KuguHome/amber-wmbus-HAT/wmbus_pihat-B.Cu.pdf

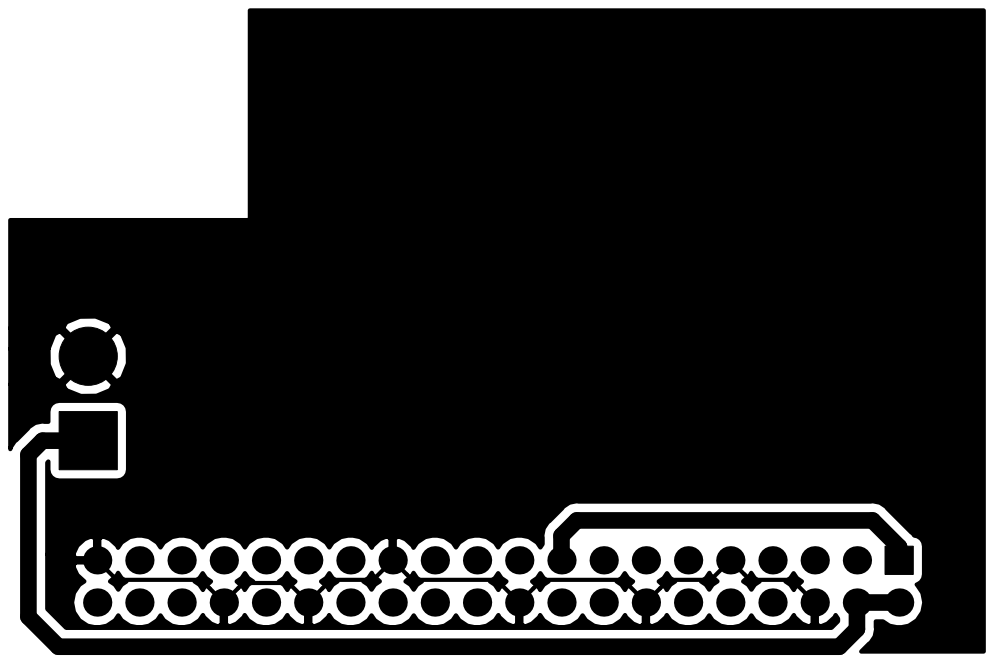
[picture p1: page 1]
