KuguHome/amber-wmbus-HAT/wmbus_pihat-B.Mask.pdf

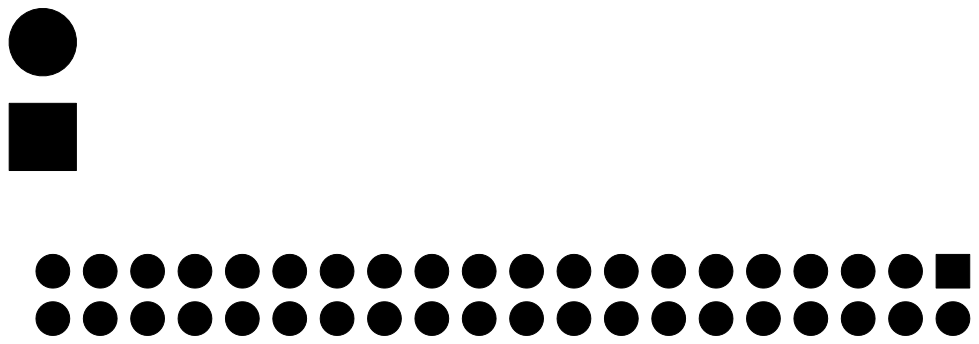
[picture p2: page 1]
