KuguHome/amber-wmbus-HAT/wmbus_pihat-F.Cu.pdf

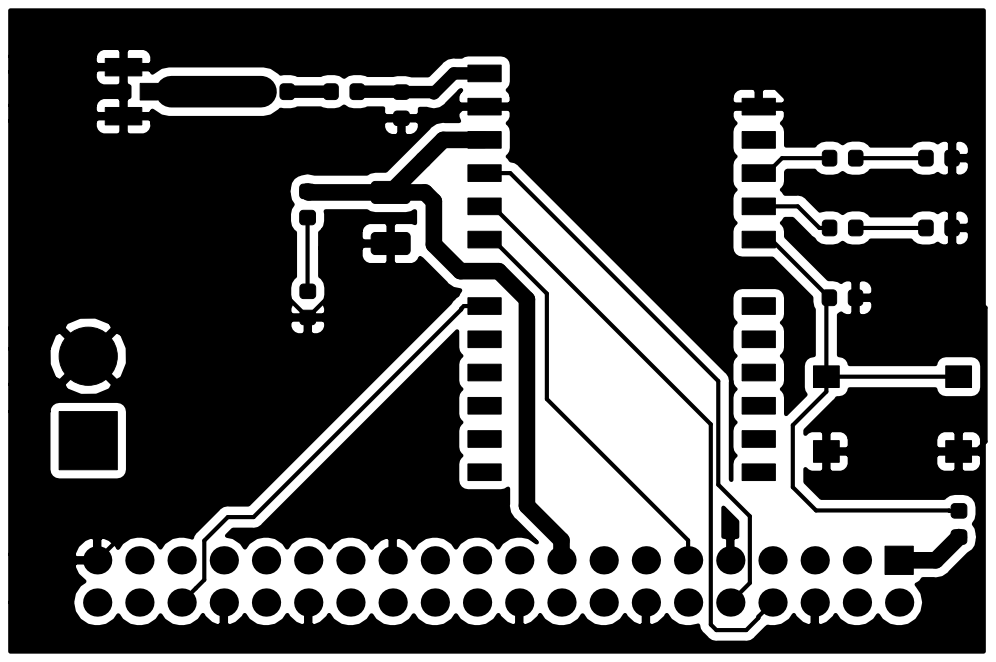
[picture p3: page 1]
