KuguHome/amber-wmbus-HAT/wmbus_pihat-F.Mask.pdf

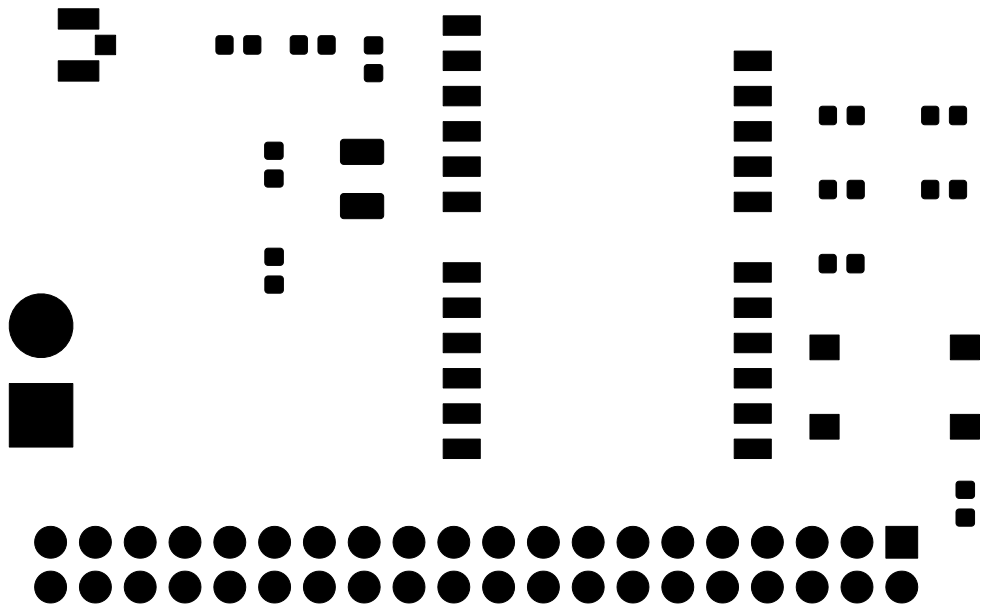
[picture p4: page 1]
