KuguHome/amber-wmbus-HAT/wmbus_pihat-F.Paste.pdf

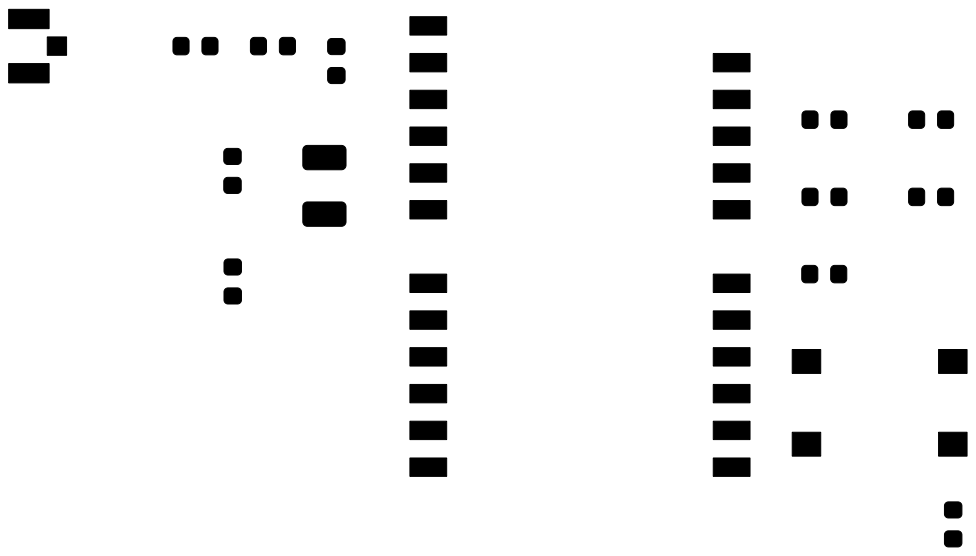
[picture p5: page 1]
