KuguHome/amber-wmbus-HAT/wmbus_pihat-F.SilkS.pdf

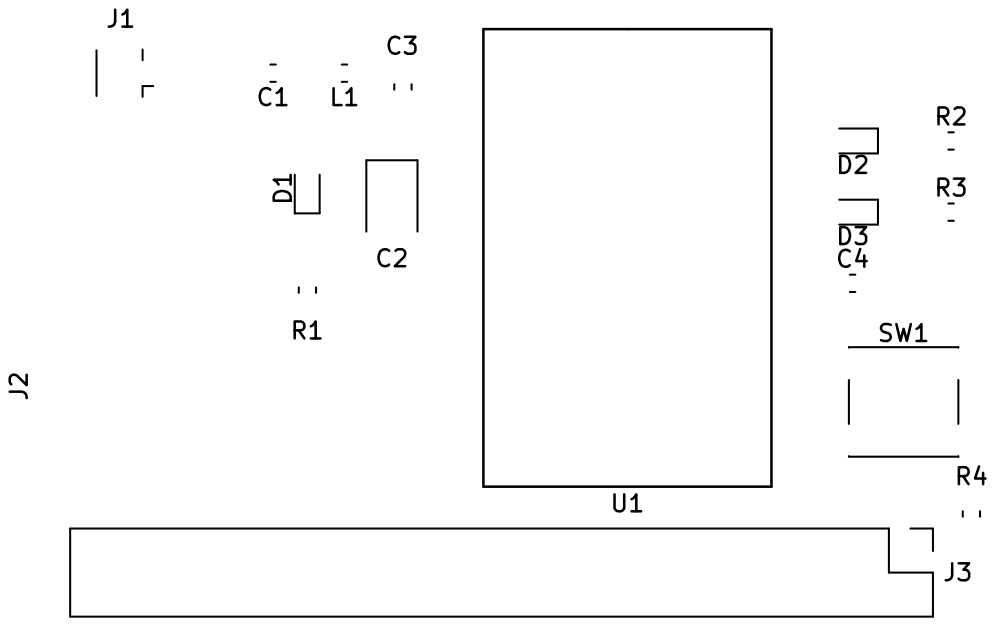
[picture p6: page 1]
