KuguHome/amber-wmbus-HAT/(commit log)

2018-11-20 wmbus-hat: first commit, board ready
    [wmbus_pihat-B.Cu.gbr, wmbus_pihat-B.Mask.gbr, wmbus_pihat-B.Paste.gbr, wmbus_pihat-B.SilkS.gbr, wmbus_pihat-Edge.Cuts.gbr, wmbus_pihat-F.Cu.gbr, wmbus_pihat-F.Mask.gbr, wmbus_pihat-F.Paste.gbr]
2019-03-21 wmbus-hat: fix amb8xxx footprint size
    [wmbus_pihat-B.Cu.gbr, wmbus_pihat-B.Mask.gbr, wmbus_pihat-B.Paste.gbr, wmbus_pihat-B.SilkS.gbr, wmbus_pihat-Edge.Cuts.gbr, wmbus_pihat-F.Cu.gbr, wmbus_pihat-F.Mask.gbr, wmbus_pihat-F.Paste.gbr]
2021-11-10 Update README.md
    https://forum.kicad.info/t/warning-avoid-all-links-to-kicad-pcb-org-use-kicad-org/31521
